longnp54/pcb_ir_robot/ir_transmitter.pdf

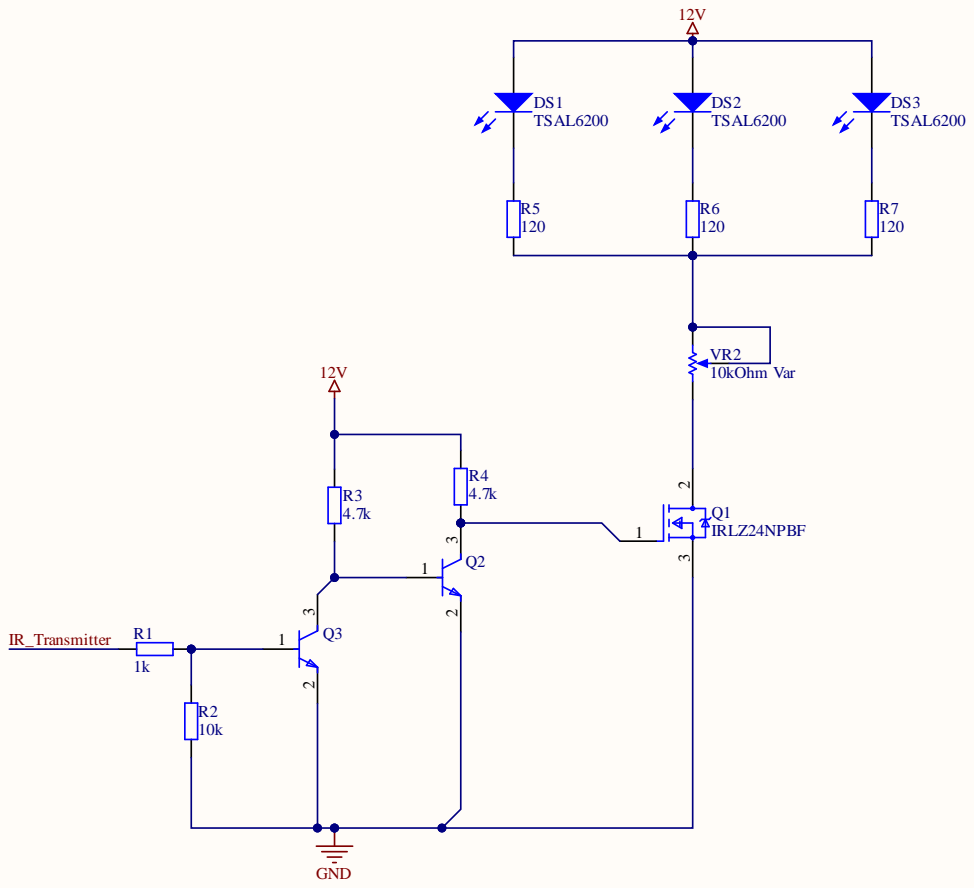
[picture p7: page 1]
