longnp54/pcb_ir_robot/main.pdf

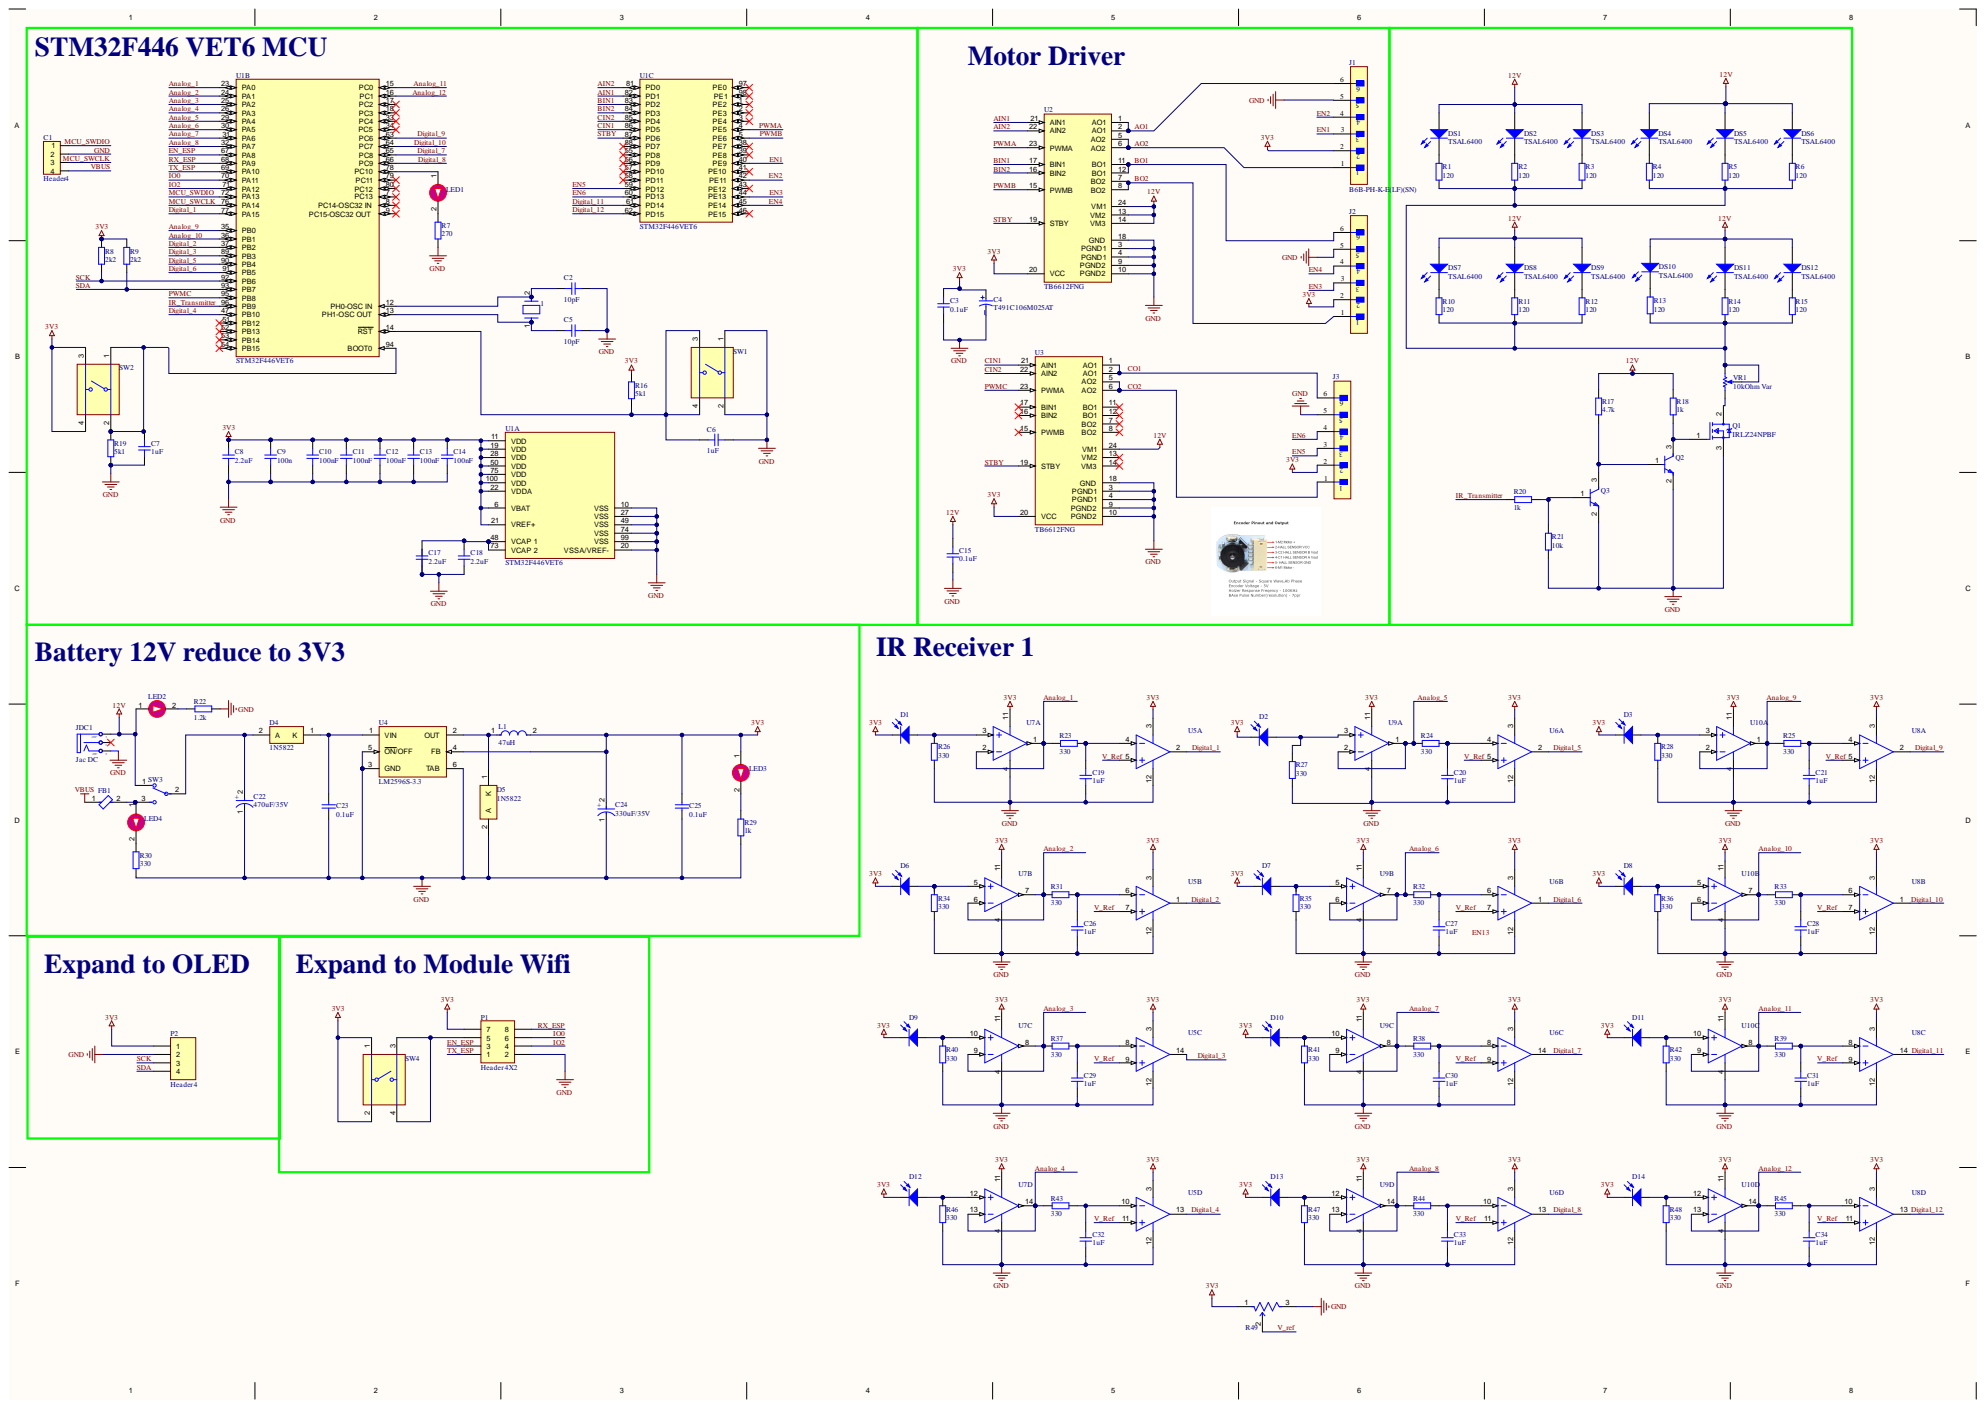
[picture p8: page 1]

Expand to Module Wifi
