longnp54/pcb_ir_robot/(list of files, drawings)

Other design files:
ir_robot.PrjPcb
main.SchDoc
