longnp54/pcb_ir_robot/(commit log)

2025-07-13 Initial commit: IR Communication Robot PCB project with schematics and documentation
    [PCB1.DRL, PCB1_Copper_Signal_Bot.gbr, PCB1_Copper_Signal_Top.gbr, PCB1_Drawing_1.gbr, PCB1_Drillmap_1.gbr, PCB1_Legend_Bot.gbr, PCB1_Legend_Top.gbr, PCB1_Mechanical_1.gbr]
2025-07-13 Update README.md: Center align STM32 and PCB badges, and enhance Acknowledgments section with emoji
2025-07-13 Update README.md: Add descriptions for STM32 and power management schematics
2025-07-13 Update README.md: Add schematic images and descriptions for PCB layout, IR array, amplifier, and motor driver circuits
